Creative-Difficulty/Haven-Vienna-badges/badges/production/bom.csv

Designator | Footprint | Quantity | Value | LCSC Part #
BT1 | BatteryHolder_MYOUNG_BS-07-A1BJ001_CR2032 | 1 | Battery_Cell
C1 | C_Radial_D6.3mm_H5.0mm_P2.50mm | 1 | 100uf
D1, D2, D3, D4, D5, D6 | LED_D5.0mm | 6 | LED
R1 | R_Axial_DIN0207_L6.3mm_D2.5mm_P7.62mm_Horizontal | 1 | 10k
R2 | R_Axial_DIN0207_L6.3mm_D2.5mm_P7.62mm_Horizontal | 1 | 1k
R3, R4, R5, R6, R7, R8 | R_Axial_DIN0207_L6.3mm_D2.5mm_P7.62mm_Horizontal | 6 | 270
SW1 | SW_PUSH_6mm | 1 | SW_Push
U1 | DIP-8_W7.62mm | 1 | LM555xN
