Creative-Difficulty/Haven-Vienna-badges/badges/badges.kicad_pcb

## KiCad design badges/badges.kicad_pcb (2026-10-18)

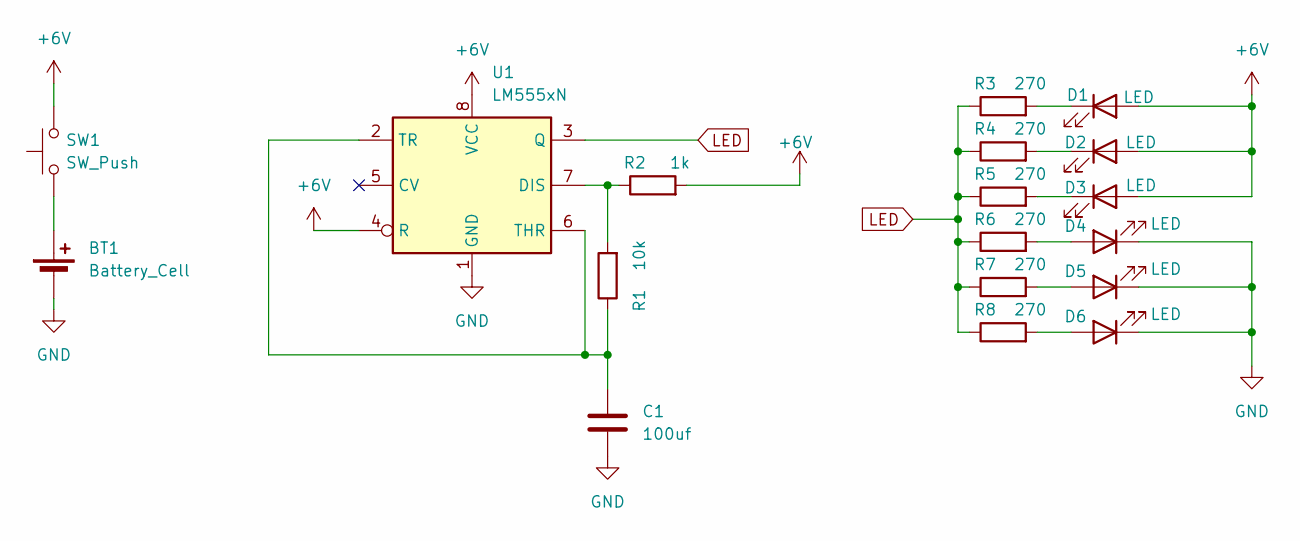
[picture p1: schematic badges.kicad_sch]

Parts:
BT1: Battery_Cell; BatteryHolder_MYOUNG_BS-07-A1BJ001_CR2032
C1: 100uf; C_Radial_D6.3mm_H5.0mm_P2.50mm
D1, D2, D3, D4, D5, D6: LED; LED_D5.0mm
R1: 10k; R_Axial_DIN0207_L6.3mm_D2.5mm_P7.62mm_Horizontal
R2: 1k; R_Axial_DIN0207_L6.3mm_D2.5mm_P7.62mm_Horizontal
R3, R4, R5, R6, R7, R8: 270; R_Axial_DIN0207_L6.3mm_D2.5mm_P7.62mm_Horizontal
SW1: SW_Push; SW_PUSH_6mm
U1: LM555xN; DIP-8_W7.62mm

Connections:
+6V: D1.2 (A), D2.2 (A), D3.2 (A), R2.2, SW1.2, U1.4 (R), U1.8 (VCC)
GND: BT1.2 (-), C1.2, D4.1 (K), D5.1 (K), D6.1 (K), U1.1 (GND)
LED: R3.1, R4.1, R5.1, R6.1, R7.1, R8.1, U1.3 (Q)
unnamed: BT1.1 (+), SW1.1
unnamed: D1.1 (K), R3.2
unnamed: D2.1 (K), R4.2
unnamed: D3.1 (K), R5.2
unnamed: D4.2 (A), R6.2
unnamed: D5.2 (A), R7.2
unnamed: D6.2 (A), R8.2
unnamed: R1.2, R2.1, U1.7 (DIS)
unnamed: C1.1, R1.1, U1.2 (TR), U1.6 (THR)

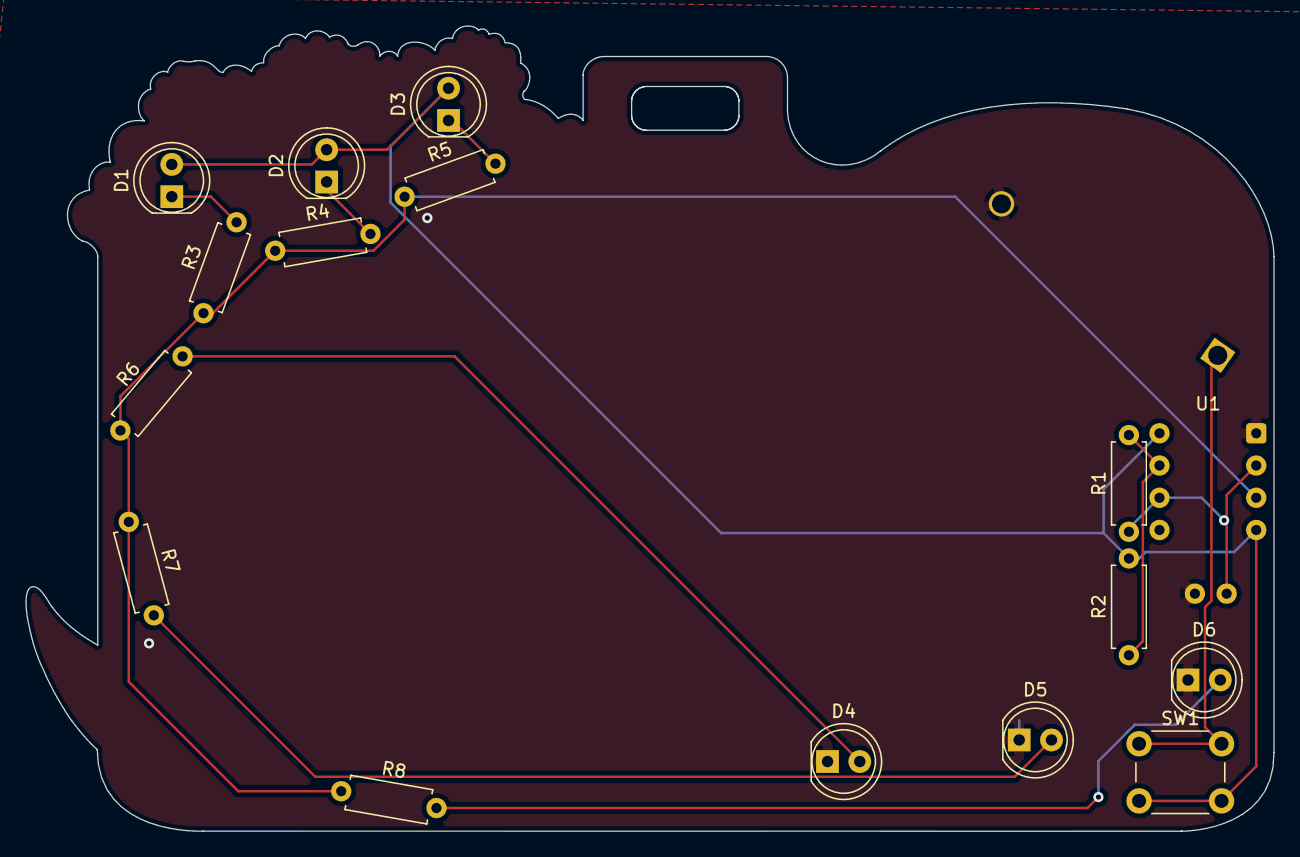
[picture p2: board badges.kicad_pcb from above]

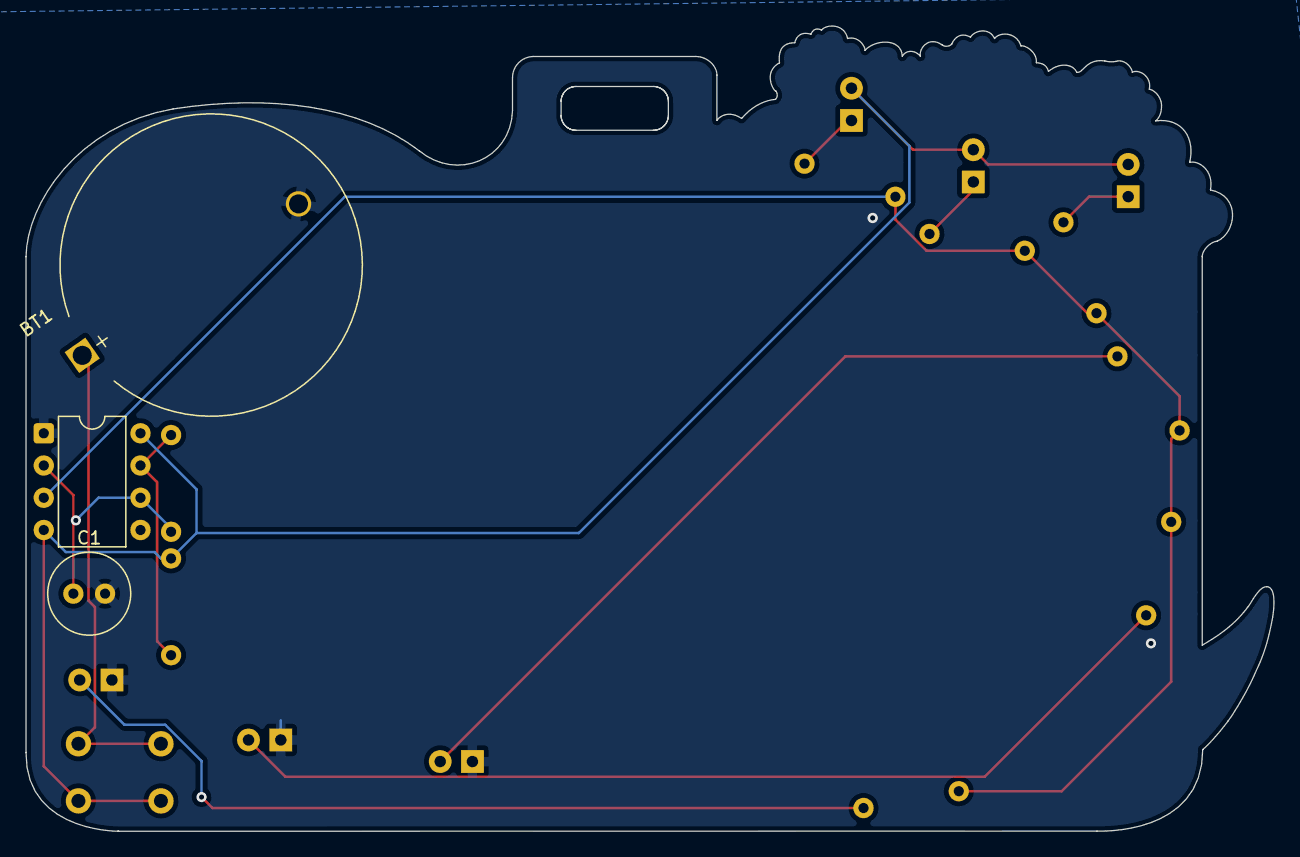
[picture p3: board badges.kicad_pcb from below]

Board: 2 copper layers, 98.3 x 63.4 mm, 18 parts (3 on the bottom side), 12 nets.
