Creative-Difficulty/Haven-Vienna-badges/uv print image/backfinal.png

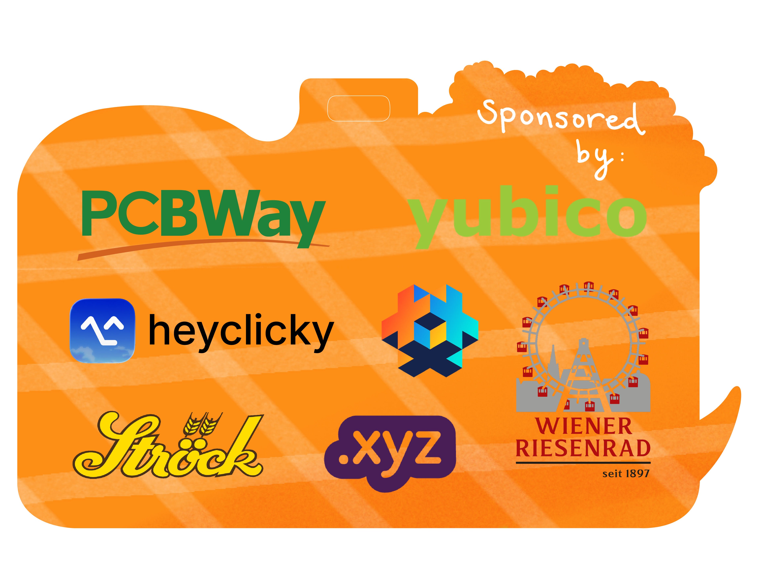
uv print image/backfinal.png
