Creative-Difficulty/Haven-Vienna-badges/uv print image/backfinalfinalfinal.png

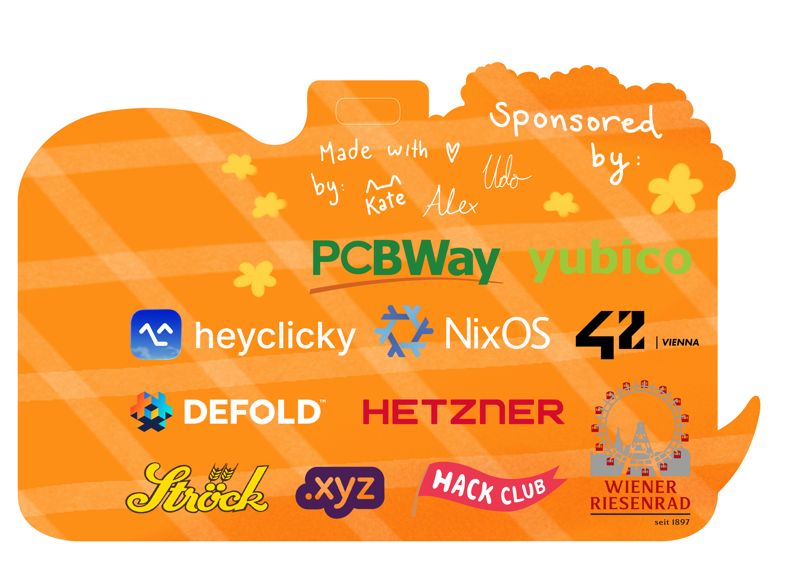
uv print image/backfinalfinalfinal.png
