Creative-Difficulty/Haven-Vienna-badges/uv print image/finalbackfinal.png

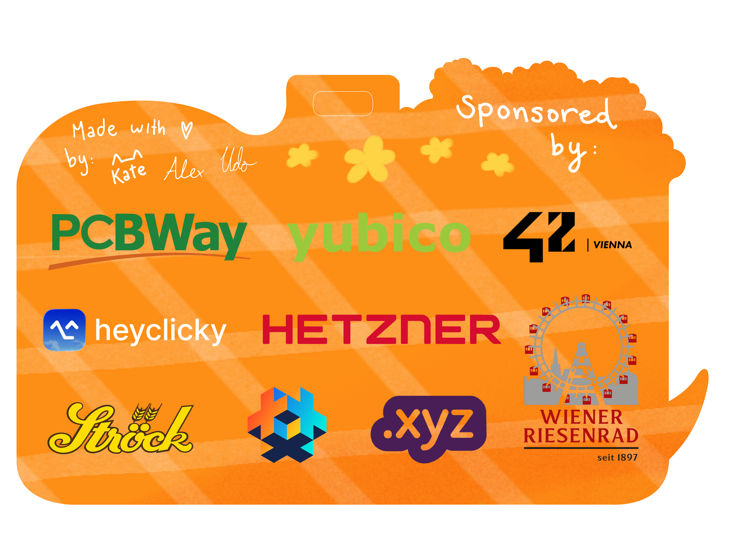
uv print image/finalbackfinal.png
