Creative-Difficulty/Haven-Vienna-badges/(commit log)

2026-09-30 image + pcb
    [badges.kicad_pcb]
2026-10-03 final hopefully
    [badges.kicad_pcb, badges.kicad_sch, bom.csv, designators.csv, positions.csv]
2026-10-18 fix: PCB Outline discontinuity
2026-10-18 fix: fill GND islands with stitching vias, add cropped back uv print image
2026-10-26 docs: add CLAUDE.md handoff notes for badge project
    Capture board facts, footprint constraints for part sourcing, circuit
    verdict (CMOS 555 required), LCSC research, PCBWay proof check and open
    UV-print issues.
2026-10-26 docs: trim CLAUDE.md to supplier-search context
    Drop everything derivable from the KiCad files; keep budget, decisions
    and sourcing research.
2026-10-26 docs: add LCSC supplier list for 75 badges
    Budget is now €100 all-in for 75 badges. Use the XD551 instead of the
    XD7555 because its output drives harder at 3 V, and rebalance the LED
    resistors (680 Ω / 100 Ω) so both LED groups light evenly.
2026-10-26 docs: add EU-only alternative supplier list
    Fallback if LCSC delivery is too risky before 14 Nov. Pollin and
    Reichelt deliver within a week but cost about €195, because no EU shop
    sells the cheap CMOS 555 clones or the BS-07 holder.
2026-10-26 docs: switch badge LEDs to green, white, orange and red
    Resistor values even out brightness across the colours; white and green
    sit on the strong side of the 555. Use the 100k/10k/10µF timing set so
    R2 no longer loads the cell while the white LED is lit.
2026-10-27 docs: order 100 of each R5 tuning resistor
    Enough 2.7k and 5.6k to retune R5 on every badge if the first test
    build calls for it. Parts total rises to $66.97.
2026-10-27 docs: add LCSC BOM upload file
    CSV of the SUPPLIERS.md order for lcsc.com/bom, with board refs as
    customer part numbers.
